matttt/balancebot2026/hardware/media/feather_v2_sch_pinout.jpg

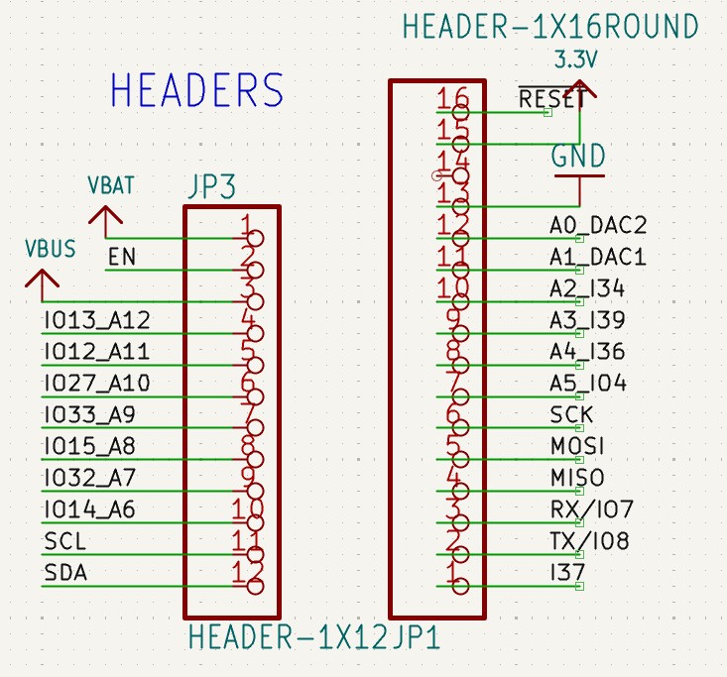
hardware/media/feather_v2_sch_pinout.jpg
