matttt/balancebot2026/hardware/media/feather_v2_pcb.jpg

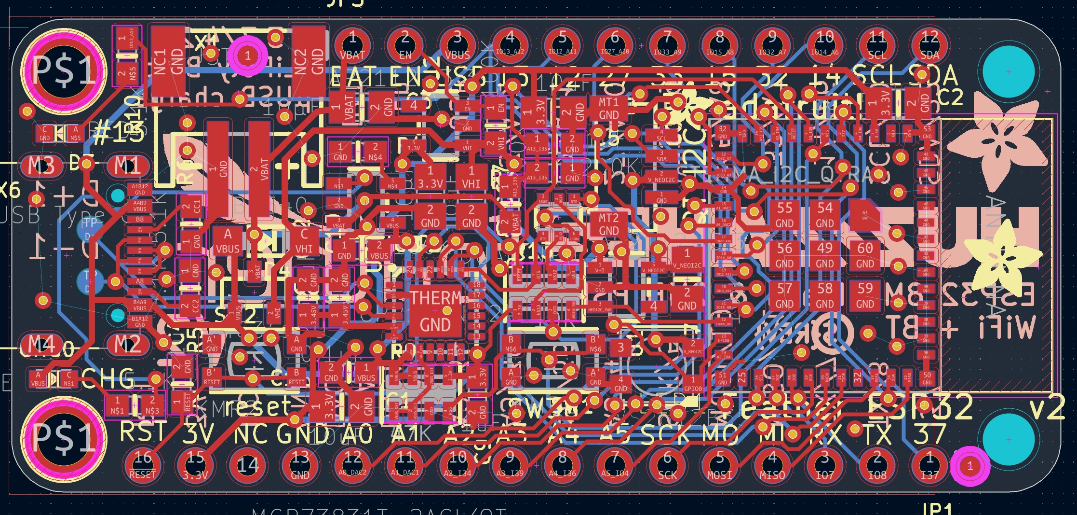
hardware/media/feather_v2_pcb.jpg
