matttt/balancebot2026/hardware/media/robot.jpg

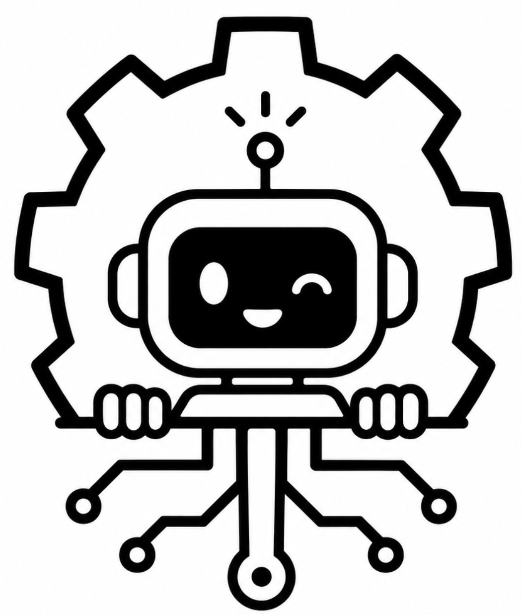
hardware/media/robot.jpg
