matttt/balancebot2026/simulation/WheeledBipedSim/worlds/.balance_sim.jpg

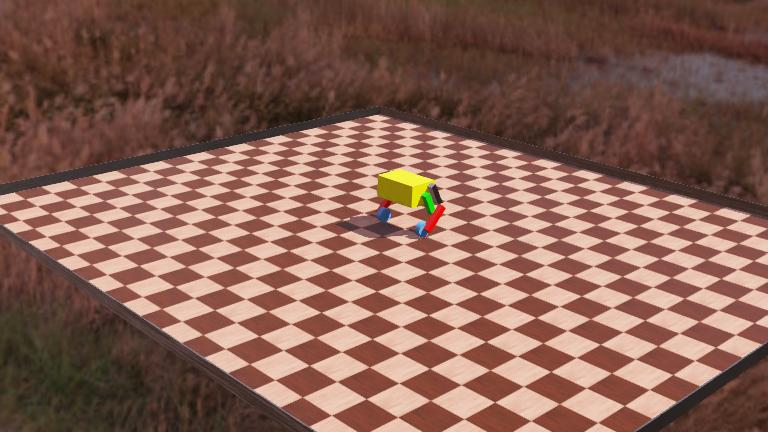
simulation/WheeledBipedSim/worlds/.balance_sim.jpg
