matttt/balancebot2026/hardware/3dmodels/Teensy_4.1_Assembly_simplified.STEP

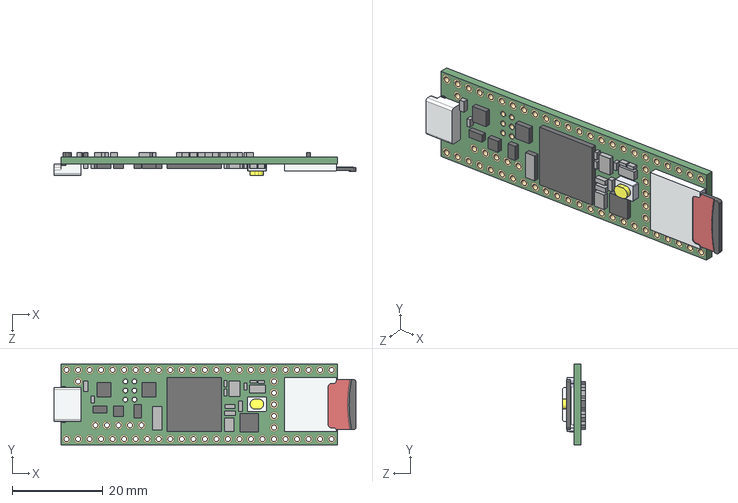
[picture p5: CAD file, 2026-08-28]
hardware/3dmodels/Teensy_4.1_Assembly_simplified.STEP
66.6 x 17.8 x 5.06 mm
