matttt/balancebot2026/hardware/3dmodels/5400 ESP32 Feather V2.step

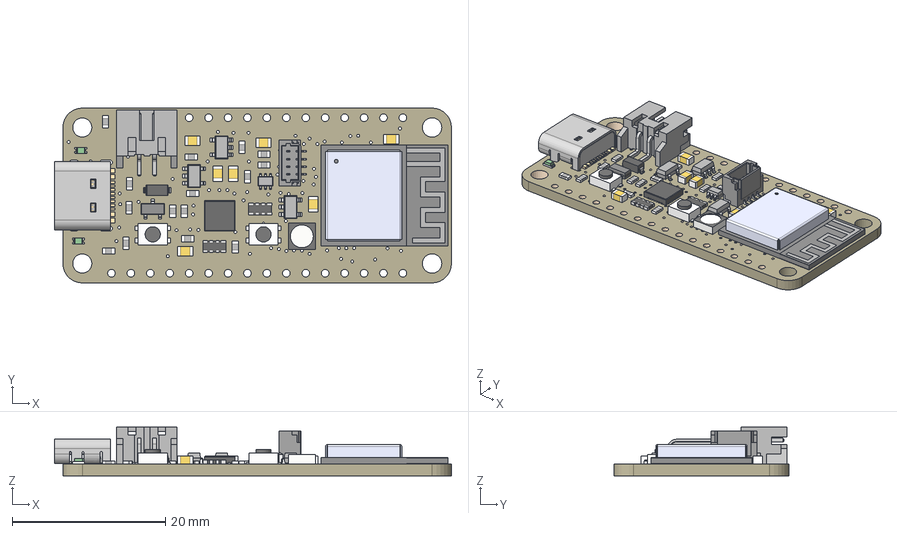
[picture p6: CAD file, 2026-08-28]
hardware/3dmodels/5400 ESP32 Feather V2.step
51.9 x 22.9 x 6.37 mm
Board
10uF x 7
AP2112-3.3 x 2
MBR540
JSTPH
MCP73831T-2ACI/OT
RED x 2
1uF x 15
KMR2 x 2
DMG3415U
47K x 2
ESP32-PICO-MINI-02MINI
WS2812B3535
STEMMA_I2C_QTRA
TPB1,27 x 2
USB Type C
CP2102N-24
DUAL NPN
