matttt/balancebot2026/hardware/3dmodels/B3P-VH.stp

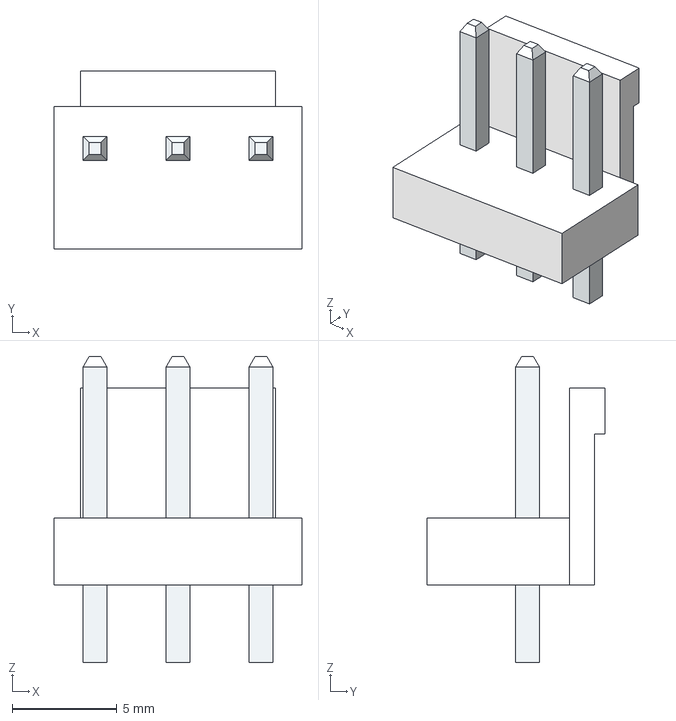
[picture p7: CAD file, 2026-08-28]
hardware/3dmodels/B3P-VH.stp
11.8 x 8.50 x 14.6 mm
