matttt/balancebot2026/hardware/3dmodels/B2P-VH--3DModel-STEP-56544.STEP

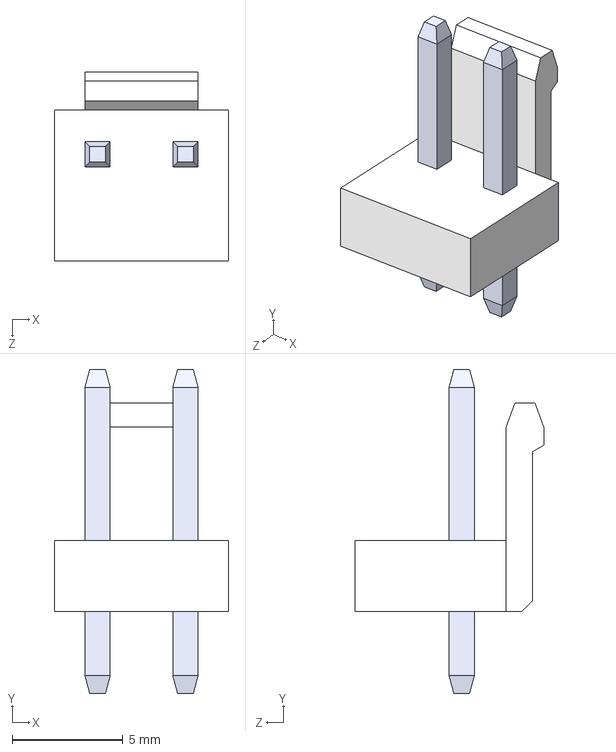
[picture p8: CAD file, 2026-08-28]
hardware/3dmodels/B2P-VH--3DModel-STEP-56544.STEP
7.86 x 14.6 x 8.50 mm
BxP-VH_2
pin x 2
