matttt/balancebot2026/hardware/3dmodels/B2P-VH.stp

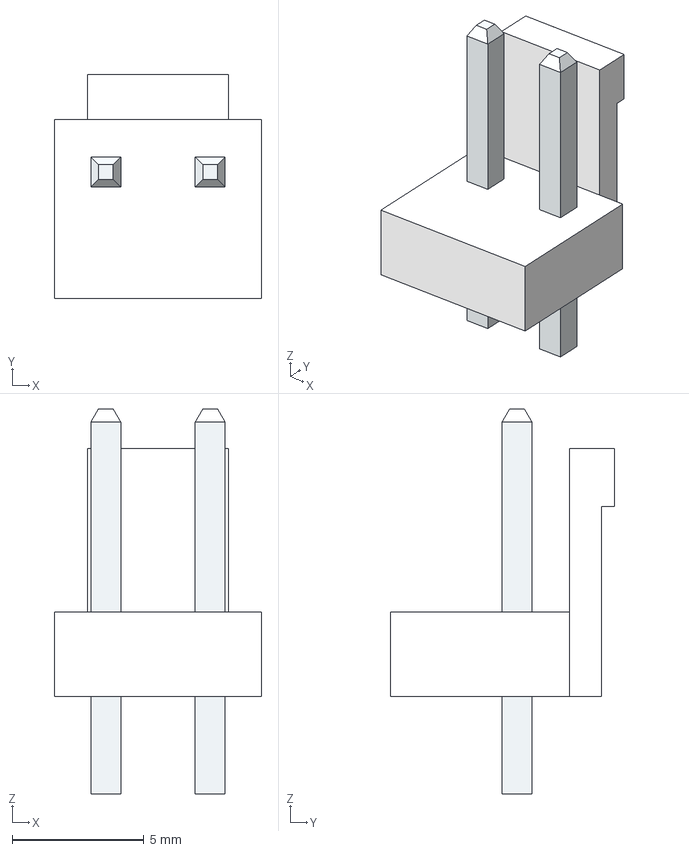
[picture p9: CAD file, 2026-08-28]
hardware/3dmodels/B2P-VH.stp
7.86 x 8.50 x 14.6 mm
