matttt/balancebot2026/hardware/3dmodels/B3PS-VH.stp

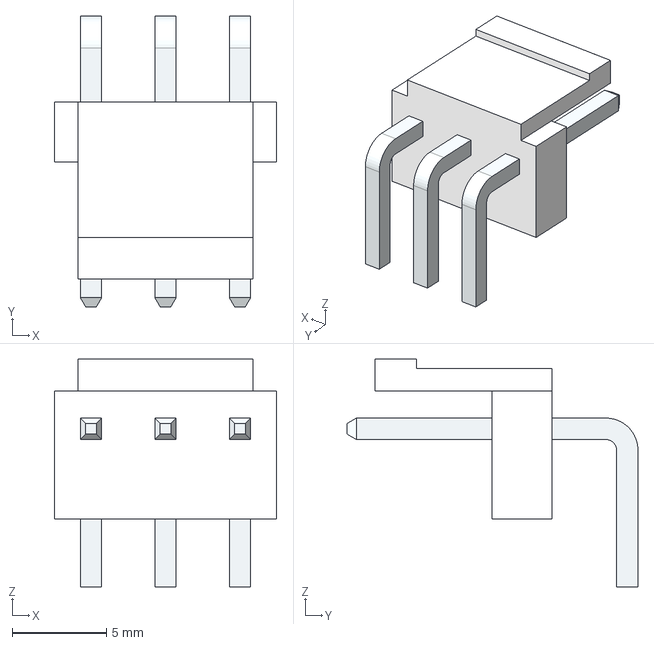
[picture p10: CAD file, 2026-08-28]
hardware/3dmodels/B3PS-VH.stp
11.8 x 15.5 x 12.1 mm
