matttt/balancebot2026/hardware/3dmodels/B2PS-VH.stp

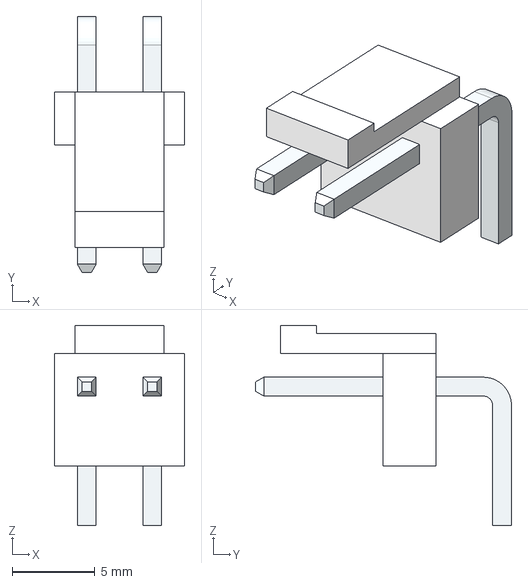
[picture p11: CAD file, 2026-08-28]
hardware/3dmodels/B2PS-VH.stp
7.86 x 15.5 x 12.1 mm
