matttt/balancebot2026/(list of files, cad)

Other CAD files:
CAD/bot.f3z
