matttt/balancebot2026/hardware/BR_mainBoard.kicad_pcb

## KiCad design hardware/BR_mainBoard.kicad_pcb (2026-08-28)

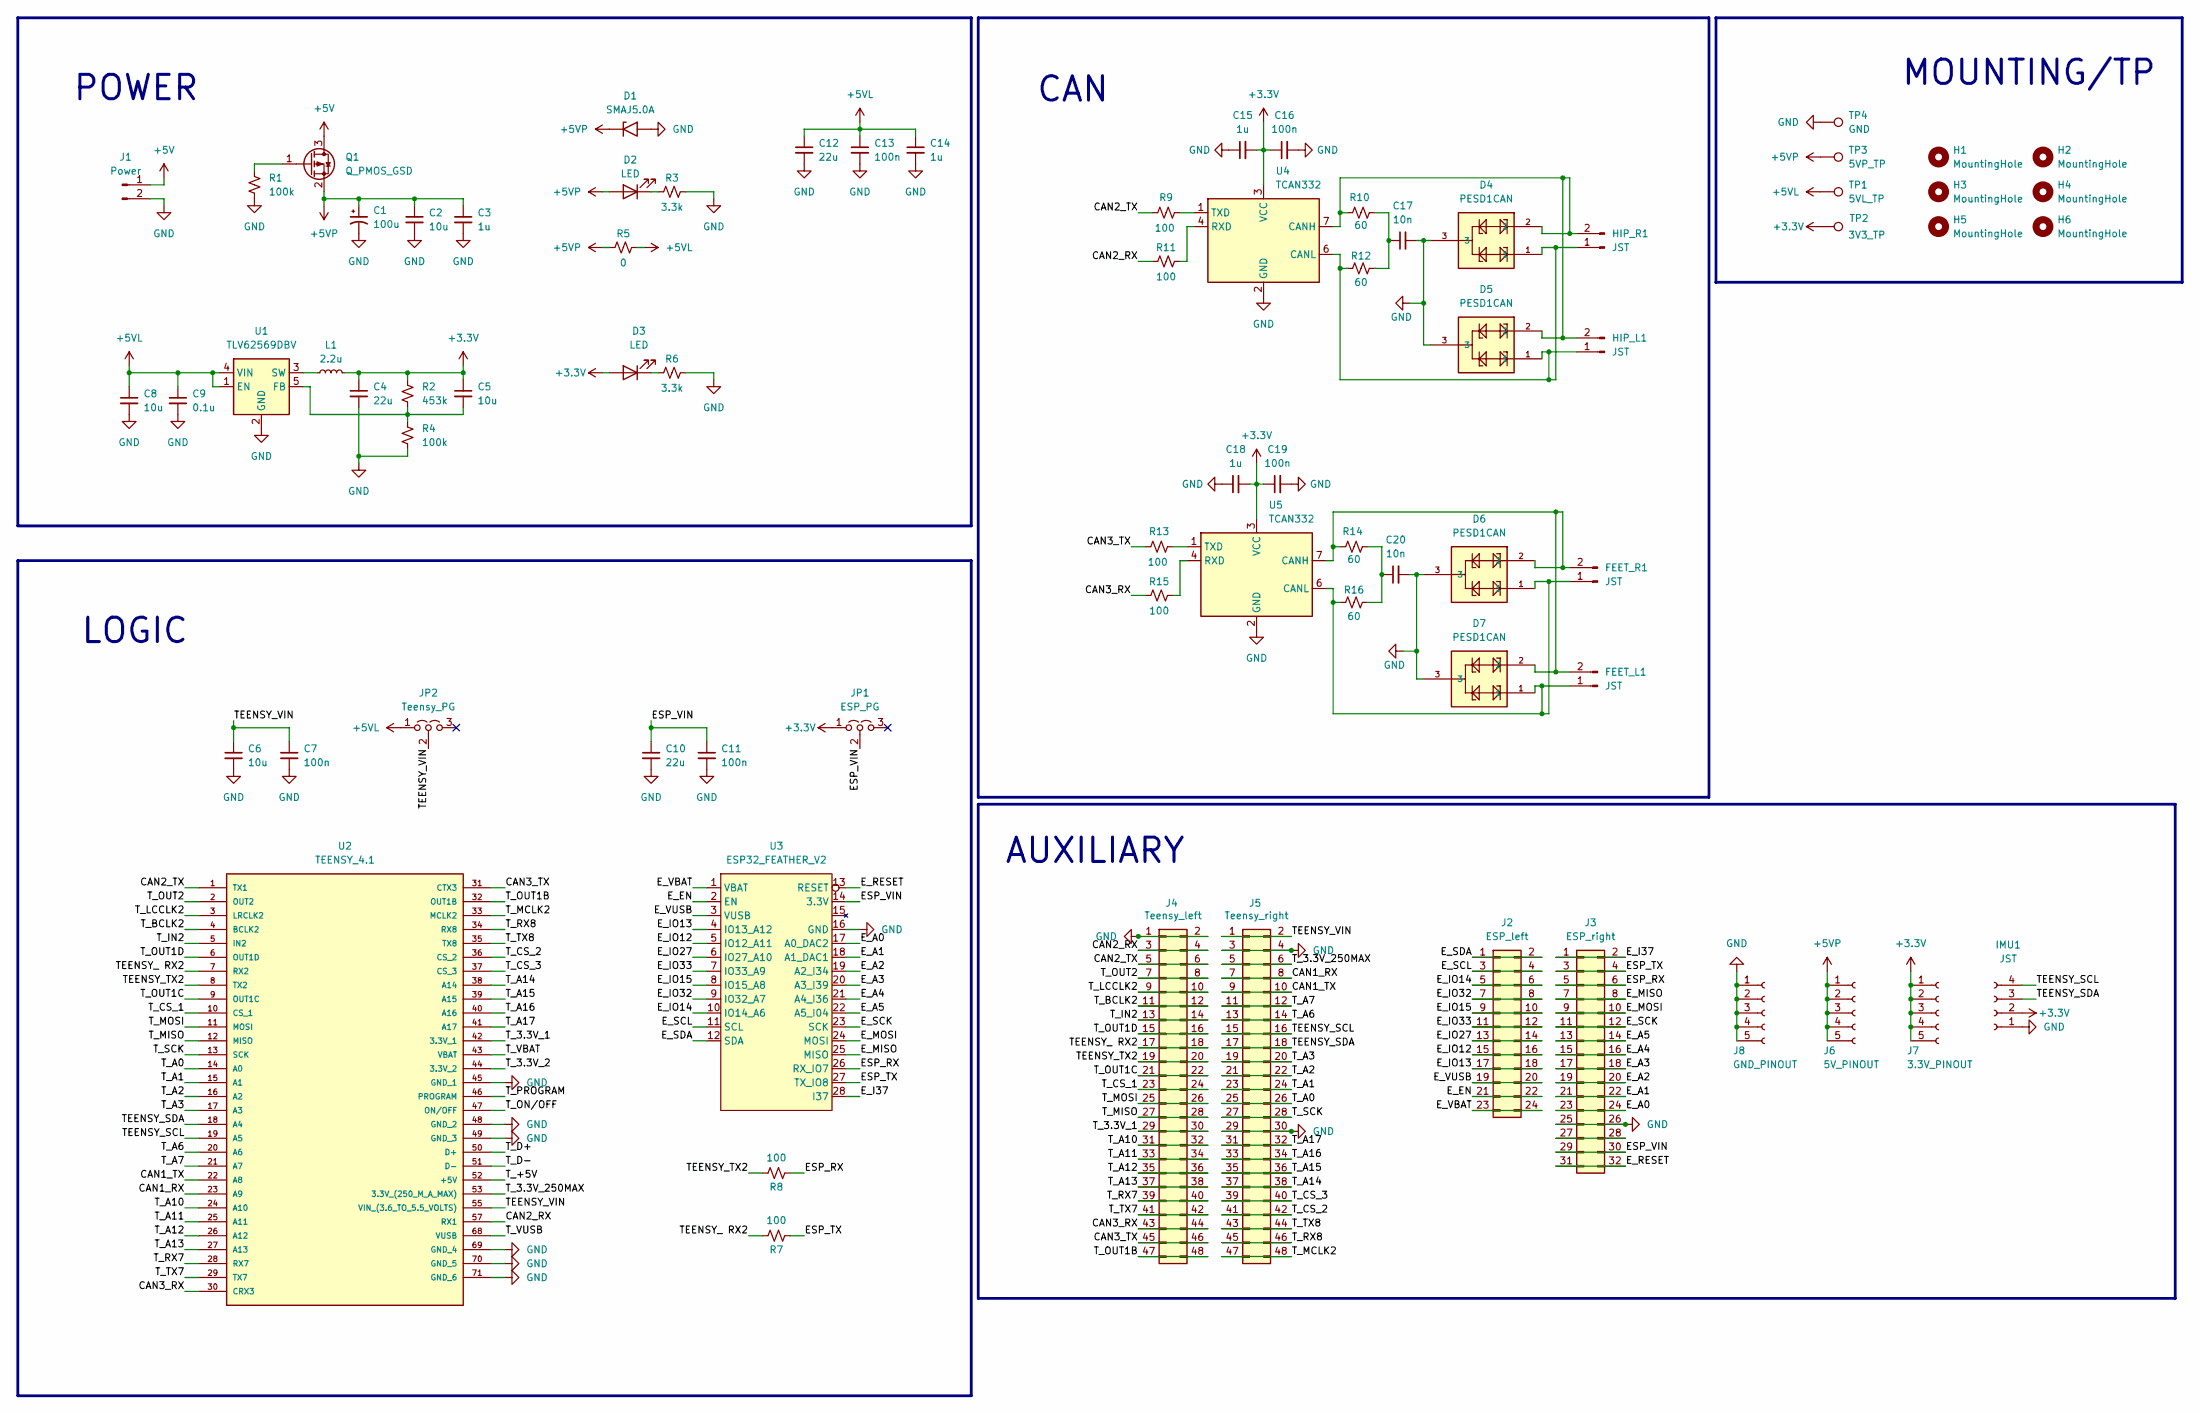
[picture p12: schematic BR_mainBoard.kicad_sch]

Parts:
C1: 100u; CP_Elec_6.3x5.4
C2, C5, C6, C8: 10u; C_1206_3216Metric
C3, C14, C15, C18: 1u; C_0805_2012Metric
C4, C10, C12: 22u; C_1206_3216Metric
C7, C11, C13, C16, C19: 100n; C_0805_2012Metric
C9: 0.1u; C_0805_2012Metric
C17, C20: 10n; C_0805_2012Metric
D1: SMAJ5.0A; D_SMA
D2, D3: LED; LED_0805_2012Metric
D4, D5, D6, D7: PESD1CAN; SOT-23
FEET_L1: JST; JST_VH_B2PS-VH_1x02_P3.96mm_Horizontal
FEET_R1: JST; JST_VH_B2PS-VH_1x02_P3.96mm_Horizontal
H1, H2, H3, H4, H5, H6: MountingHole; MountingHole_3.2mm_M3
HIP_L1: JST; JST_VH_B2PS-VH_1x02_P3.96mm_Horizontal
HIP_R1: JST; JST_VH_B2PS-VH_1x02_P3.96mm_Horizontal
IMU1: JST; JST_PH_S4B-PH-K_1x04_P2.00mm_Horizontal
J1: Power; JST_VH_B2P-VH-FB-B_1x02_P3.96mm_Vertical
J2: ESP_left; PinSocket_2x12_P2.54mm_Vertical
J3: ESP_right; PinSocket_2x16_P2.54mm_Vertical
J4: Teensy_left; PinSocket_2x24_P2.54mm_Vertical
J5: Teensy_right; PinSocket_2x24_P2.54mm_Vertical
J6: 5V_PINOUT; PinSocket_1x05_P2.54mm_Vertical
J7: 3.3V_PINOUT; PinSocket_1x05_P2.54mm_Vertical
J8: GND_PINOUT; PinSocket_1x05_P2.54mm_Vertical
JP1: ESP_PG; PinHeader_1x03_P2.54mm_Vertical
JP2: Teensy_PG; PinHeader_1x03_P2.54mm_Vertical
L1: 2.2u; L_Coilcraft_XAL4020-XXX
Q1: Q_PMOS_GSD; SOT-23
R1, R4: 100k; R_0805_2012Metric
R2: 453k; R_0805_2012Metric
R3, R6: 3.3k; R_0805_2012Metric
R5: 0; R_0805_2012Metric
R7, R8, R9, R11, R13, R15: 100; R_0805_2012Metric
R10, R12, R14, R16: 60; R_0603_1608Metric
TP1: 5VL_TP; TestPoint_Loop_D2.50mm_Drill1.0mm
TP2: 3V3_TP; TestPoint_Loop_D2.50mm_Drill1.0mm
TP3: 5VP_TP; TestPoint_Loop_D2.50mm_Drill1.0mm
TP4: GND; TestPoint_Loop_D2.50mm_Drill1.0mm
U1: TLV62569DBV; SOT-23-5
U2: TEENSY_4.1; TEENSY41; Manufacturer_Part_Number TEENSY 4.1
U3: ESP32_FEATHER_V2
U4, U5: TCAN332; SOIC-8_3.9x4.9mm_P1.27mm

Connections:
+3.3V: C4.1, C5.1, C15.2, C16.1, C18.2, C19.1, D3.2 (A), IMU1.2, J7.1, J7.2, J7.3, J7.4, J7.5, JP1.1 (A), L1.2, R2.1, TP2.1 (1_1), U4.3 (VCC), U5.3 (VCC)
+5V: J1.1, Q1.3 (D)
+5VL: C8.1, C9.1, C12.1, C13.1, C14.1, JP2.1 (A), R5.2, TP1.1 (1_1), U1.1 (EN), U1.4 (VIN)
+5VP: C1.1, C2.1, C3.1, D1.1 (A1), D2.2 (A), J6.1, J6.2, J6.3, J6.4, J6.5, Q1.2 (S), R5.1, TP3.1 (1_1)
/CAN1_RX: J5.7, J5.8, U2.23 (A9)
/CAN1_TX: J5.9, J5.10, U2.22 (A8)
/CAN2_RX: J4.3, J4.4, R11.1, U2.57 (RX1)
/CAN2_TX: J4.5, J4.6, R9.1, U2.1 (TX1)
/CAN3_RX: J4.43, J4.44, R15.1, U2.30 (CRX3)
/CAN3_TX: J4.45, J4.46, R13.1, U2.31 (CTX3)
/ESP_RX: J3.5, J3.6, R8.1, U3.26 (RX_IO7)
/ESP_TX: J3.3, J3.4, R7.1, U3.27 (TX_IO8)
/ESP_VIN: C10.1, C11.1, J3.29, J3.30, JP1.2 (C), U3.14 (3.3V)
/E_A0: J3.23, J3.24, U3.17 (A0_DAC2)
/E_A1: J3.21, J3.22, U3.18 (A1_DAC1)
/E_A2: J3.19, J3.20, U3.19 (A2_I34)
/E_A3: J3.17, J3.18, U3.20 (A3_I39)
/E_A4: J3.15, J3.16, U3.21 (A4_I36)
/E_A5: J3.13, J3.14, U3.22 (A5_I04)
/E_EN: J2.21, J2.22, U3.2 (EN)
/E_I37: J3.1, J3.2, U3.28 (I37)
/E_IO12: J2.15, J2.16, U3.5 (IO12_A11)
/E_IO13: J2.17, J2.18, U3.4 (IO13_A12)
/E_IO14: J2.5, J2.6, U3.10 (IO14_A6)
/E_IO15: J2.9, J2.10, U3.8 (IO15_A8)
/E_IO27: J2.13, J2.14, U3.6 (IO27_A10)
/E_IO32: J2.7, J2.8, U3.9 (IO32_A7)
/E_IO33: J2.11, J2.12, U3.7 (IO33_A9)
/E_MISO: J3.7, J3.8, U3.25 (MISO)
/E_MOSI: J3.9, J3.10, U3.24 (MOSI)
/E_RESET: J3.31, J3.32, U3.13 (RESET)
/E_SCK: J3.11, J3.12, U3.23 (SCK)
/E_SCL: J2.3, J2.4, U3.11 (SCL)
/E_SDA: J2.1, J2.2, U3.12 (SDA)
/E_VBAT: J2.23, J2.24, U3.1 (VBAT)
/E_VUSB: J2.19, J2.20, U3.3 (VUSB)
/TEENSY_ RX2: J4.17, J4.18, R7.2, U2.7 (RX2)
/TEENSY_SCL: IMU1.4, J5.15, J5.16, U2.19 (A5)
/TEENSY_SDA: IMU1.3, J5.17, J5.18, U2.18 (A4)
/TEENSY_TX2: J4.19, J4.20, R8.2, U2.8 (TX2)
/TEENSY_VIN: C6.1, C7.1, J5.1, J5.2, JP2.2 (C), U2.55 (VIN_(3.6_TO_5.5_VOLTS))
/T_3.3V_1: J4.29, J4.30, U2.42 (3.3V_1)
/T_3.3V_2: U2.44 (3.3V_2)
/T_3.3V_250MAX: J5.5, J5.6, U2.53 (3.3V_(250_M_A_MAX))
/T_+5V: U2.52 (+5V)
/T_A0: J5.25, J5.26, U2.14 (A0)
/T_A1: J5.23, J5.24, U2.15 (A1)
/T_A2: J5.21, J5.22, U2.16 (A2)
/T_A3: J5.19, J5.20, U2.17 (A3)
/T_A6: J5.13, J5.14, U2.20 (A6)
/T_A7: J5.11, J5.12, U2.21 (A7)
/T_A10: J4.31, J4.32, U2.24 (A10)
/T_A11: J4.33, J4.34, U2.25 (A11)
/T_A12: J4.35, J4.36, U2.26 (A12)
/T_A13: J4.37, J4.38, U2.27 (A13)
/T_A14: J5.37, J5.38, U2.38 (A14)
/T_A15: J5.35, J5.36, U2.39 (A15)
/T_A16: J5.33, J5.34, U2.40 (A16)
/T_A17: J5.31, J5.32, U2.41 (A17)
/T_BCLK2: J4.11, J4.12, U2.4 (BCLK2)
/T_CS_1: J4.23, J4.24, U2.10 (CS_1)
/T_CS_2: J5.41, J5.42, U2.36 (CS_2)
/T_CS_3: J5.39, J5.40, U2.37 (CS_3)
/T_D+: U2.50 (D+)
/T_D-: U2.51 (D-)
/T_IN2: J4.13, J4.14, U2.5 (IN2)
/T_LCCLK2: J4.9, J4.10, U2.3 (LRCLK2)
/T_MCLK2: J5.47, J5.48, U2.33 (MCLK2)
/T_MISO: J4.27, J4.28, U2.12 (MISO)
/T_MOSI: J4.25, J4.26, U2.11 (MOSI)
/T_ON/OFF: U2.47 (ON/OFF)
/T_OUT1B: J4.47, J4.48, U2.32 (OUT1B)
/T_OUT1C: J4.21, J4.22, U2.9 (OUT1C)
/T_OUT1D: J4.15, J4.16, U2.6 (OUT1D)
/T_OUT2: J4.7, J4.8, U2.2 (OUT2)
/T_PROGRAM: U2.46 (PROGRAM)
/T_RX7: J4.39, J4.40, U2.28 (RX7)
/T_RX8: J5.45, J5.46, U2.34 (RX8)
/T_SCK: J5.27, J5.28, U2.13 (SCK)
/T_TX7: J4.41, J4.42, U2.29 (TX7)
/T_TX8: J5.43, J5.44, U2.35 (TX8)
/T_VBAT: U2.43 (VBAT)
/T_VUSB: U2.68 (VUSB)
GND: C1.2, C2.2, C3.2, C4.2, C6.2, C7.2, C8.2, C9.2, C10.2, C11.2, C12.2, C13.2, C14.2, C15.1, C16.2, C17.2, C18.1, C19.2, C20.2, D1.2 (A2), D4.3, D5.3, D6.3, D7.3, IMU1.1, J1.2, J3.25, J3.26, J4.1, J4.2, J5.3, J5.4, J5.29, J5.30, J8.1, J8.2, J8.3, J8.4, J8.5, R1.2, R3.2, R4.2, R6.2, TP4.1 (1_1), U1.2 (GND), U2.45 (GND_1), U2.48 (GND_2), U2.49 (GND_3), U2.69 (GND_4), U2.70 (GND_5), U2.71 (GND_6), U3.16 (GND), U4.2 (GND), U5.2 (GND)
unnamed: C17.1, R10.2, R12.2
unnamed: C20.1, R14.2, R16.2
unnamed: D2.1 (K), R3.1
unnamed: D3.1 (K), R6.1
unnamed: D6.1, D7.1, FEET_L1.1, FEET_R1.1, R16.1, U5.6 (CANL)
unnamed: D6.2, D7.2, FEET_L1.2, FEET_R1.2, R14.1, U5.7 (CANH)
unnamed: D4.1, D5.1, HIP_L1.1, HIP_R1.1, R12.1, U4.6 (CANL)
unnamed: D4.2, D5.2, HIP_L1.2, HIP_R1.2, R10.1, U4.7 (CANH)
unnamed: J3.27, J3.28
unnamed: Q1.1 (G), R1.1
unnamed: C5.2, R2.2, R4.1, U1.5 (FB)
unnamed: L1.1, U1.3 (SW)
unnamed: R11.2, U4.4 (RXD)
unnamed: R9.2, U4.1 (TXD)
unnamed: R15.2, U5.4 (RXD)
unnamed: R13.2, U5.1 (TXD)

Notes on the sheet:
CAN
MOUNTING/TP
LOGIC
POWER
AUXILIARY

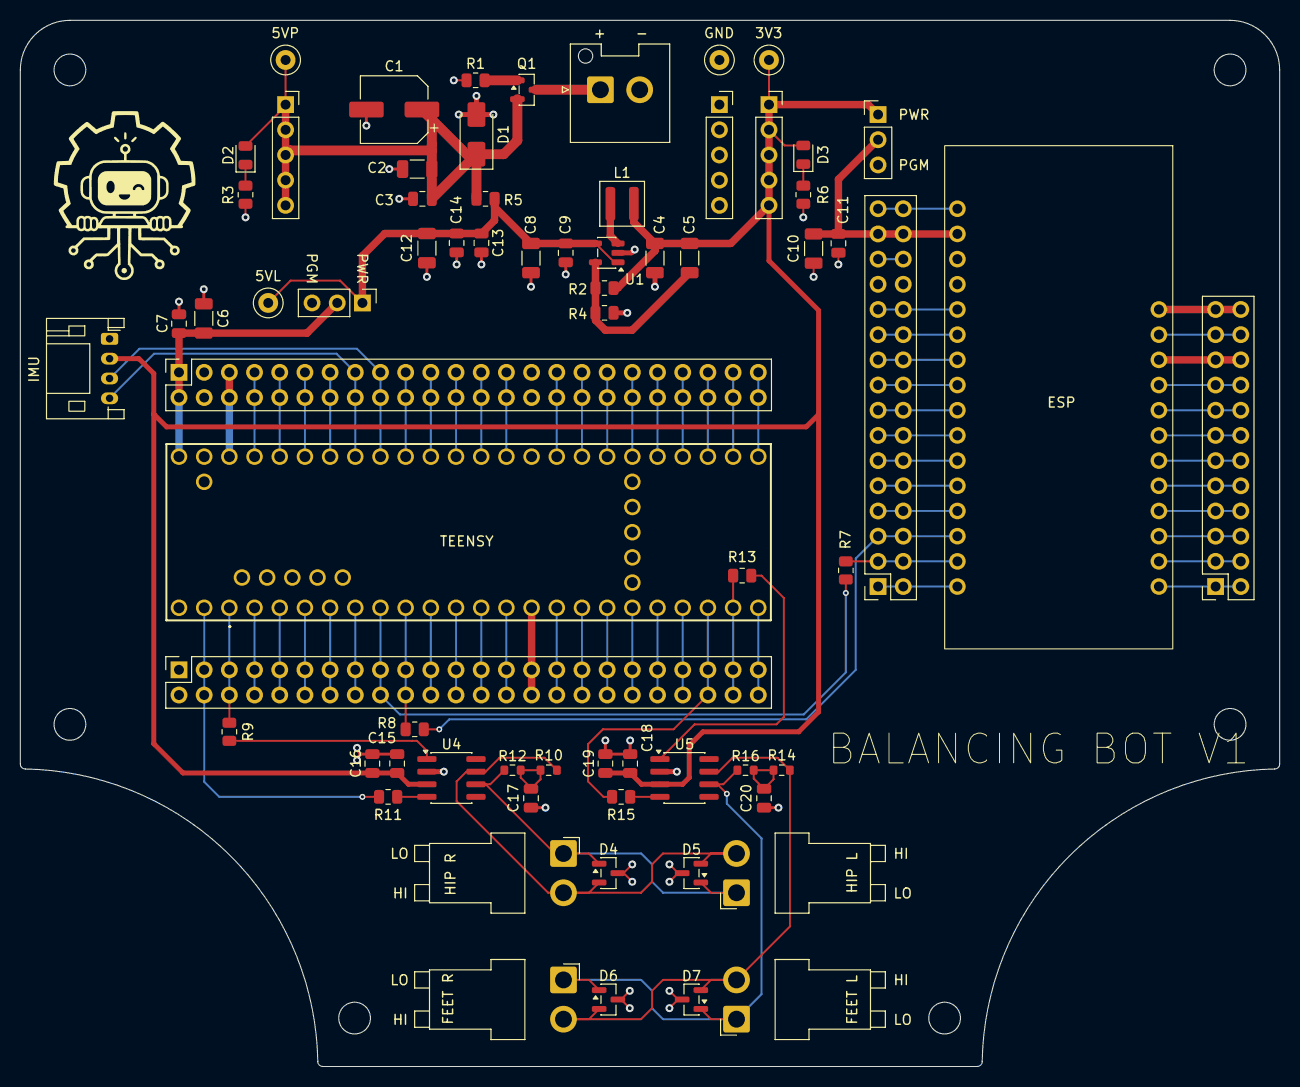
[picture p13: board BR_mainBoard.kicad_pcb from above]

Board: 2 copper layers, 127.0 x 105.5 mm, 75 parts (0 on the bottom side), 92 nets.
