matttt/balancebot2026/(commit log)

2026-02-16 init commit with basic esp32 firmware example for can communication
2026-02-17 hip actuator demo
    basic demo that shows sine wave behavior with actuator. Formalizes basic CAN structure.
2026-02-25 added pio structure to teensy
2026-02-28 Add webots sim and two-wheeled inverted pendulum analysis model
2026-02-28 Add WheeledBipedSim README
2026-03-03 added esp_teensy_comm.cpp
    created esp_teensy_comm.cpp to interface with teensy, currently runs as a sine wave demo with proper hardware connected.
2026-04-13 Added BNO-055 IMU support
2026-05-25 serial cli for rob stride motor
2026-08-28 initial hw commit
    full kicad project with sch, pcb, gerber, symbols, and 3d electrical CAD models
    [5400 ESP32 Feather V2.step, B2P-VH--3DModel-STEP-56544.STEP, B2P-VH.stp, B2PS-VH.stp, B3P-VH.stp, B3PS-VH.stp, BR_mainBoard.kicad_pcb, BR_mainBoard.kicad_sch]
